IslamAsar/Autonomous-Obstacle-Avoidance-Robot/(list of files, drawings)

Other design files:
PCB/PCB Design.json
Schematic.fz
